Wentaobi/Micro-Controller/README.md

# Micro-Controller
Autonomous Object Tracking Robot with Object Avoidance

Our Project Goals were
Design an autonomous system to search a space for an object of a particular color
Track and follow or avoid the object
Send real time environmental data to a remote computer
Display the robots environment on the computer in real time.
Overall, the project’s focus was on the integration of disparate chassis, sensor, and logic modules into a single functioning system.
